Jordan18122000/projet_esp32_src/30_src/readme.md

Sous-modules : librairies logicielles, scripts partagés, ….
