Jordan18122000/projet_esp32_src/30_src/ESP32/Empreintes.xlsx

NAME | Description | Designator | Qty | MP | Manufacturer | Footprint | V | Check
114020164 | Seeed Studio Accessories Grove Female Header - SMD-4P-2.0mm-90D-20Pcs | J202, J203 | 2 | KO | KO | 114020164 | NA | OK
598-8610-207F | Standard LEDs - SMD Red/Green WC 80/50mcd 645/570nm | D600 | 1 | KO | KO | 5988610207F | NA
0.1uF | Capa | C101, C104, C108, C300, C500 | 5 | KO | KO | CAPA_0603 | NA | OK
0.6pF | Capa | C600 | 1 | KO | KO | CAPA_0603 | NA | OK
0.9pF | Capa | C601 | 1 | KO | KO | CAPA_0603 | NA | OK
1nF | Capa | C105 | 1 | KO | KO | CAPA_0603 | NA | OK
1.0pF | Capa | C602 | 1 | KO | KO | CAPA_0603 | NA | OK
1uF | Capa | C100, C102, C103, C107, C303, C304 | 6 | KO | KO | CAPA_0603 | NA | OK
2.2uF | Capa | C302 | 1 | KO | KO | CAPA_0603 | NA | OK
4.7uF | Capa | C106 | 1 | KO | KO | CAPA_0603 | NA | OK
5mF | Capa | C400 | 1 | KO | KO | CAPA_0603 | NA | OK
10uF | Capa | C301 | 1 | KO | KO | CAPA_0603 | NA | OK
22uF | Capa | C305 | 1 | KO | KO | CAPA_0603 | NA | OK
47nF | Capa | C603, C604, C605, C606 | 4 | KO | KO | CAPA_0603 | NA | OK
100nF | Capa | C200, C401, C402, C403, C404, C405, C406, C407, C501, C502 | 10 | KO | KO | CAPA_0603 | NA | OK
825433-8 | Headers & Wire Housings 8P double for connection mikrobus | J200 | 1 | KO | KO | Connect-Mikrobus | NA
4.7uH | Self | L300 | 1 | KO | KO | LQPC1005X06N | NA
10uF | Capa | L301 | 1 | KO | KO | LQPC1005X06N | NA
NCP167BMX330TBG | Régulateurs de tension LDO LDO 700 MA ULTRA-LOW NOISE 3.3V | U300 | 1 | KO | KO | NCP167BMX330TBG | NA
CP2104-F03-GM | USB Bridge, USB to UART USB 2.0 UART Interface 24-QFN (4x4) | U101 | 1 | KO | KO | PQFN50P400X400X80_HS-25N | NA
ESP32-PICO-D4 | Système RF sur puce - SoC SIP module ESP32 with 4MByte Flash, Dual Core MCU, Wi-Fi & Bluetooth Combo, LGA48-pin, 7*7mm | U100 | 1 | KO | KO | PQFN50P700X700X104_HS-49N | NA
1K | Résistance | R600, R603 | 2 | KO | KO | RES_0603 | NA | OK
2K | Résistance | R502, R503 | 2 | KO | KO | RES_0603 | NA | OK
4.7K | Résistance | R100 | 1 | KO | KO | RES_0603 | NA | OK
5K1 | Résistance | R200, R201 | 2 | KO | KO | RES_0603 | NA | OK
5.1K | Résistance | R605, R607 | 2 | KO | KO | RES_0603 | NA | OK
10K | Résistance | R101, R102, R104, R401, R403, R405, R500, R501, R604, R606 | 10 | KO | KO | RES_0603 | NA | OK
10R | Résistance | R504, R505 | 2 | KO | KO | RES_0603 | NA | OK
22.1K | Résistance | R301 | 1 | KO | KO | RES_0603 | NA | OK
51K | Résistance | R300 | 1 | KO | KO | RES_0603 | NA | OK
100k | Résistance | R302 | 1 | KO | KO | RES_0603 | NA | OK
100K | Résistance | R400, R402, R404 | 3 | KO | KO | RES_0603 | NA | OK
150R | Résistance | R601, R602 | 2 | KO | KO | RES_0603 | NA | OK
510R | Résistance | R103 | 1 | KO | KO | RES_0603 | NA | OK
PSR400ITQFF0L50 | ROHM - PSR400ITQFF0L50 - SMD Current Sense Resistor, 500 ohm, PSR Series, 3921 [1052 Metric], 4 W, +/- 1%, Metal Strip | X500 | 1 | KO | KO | RESC10052X200N | NA
NB12K00103JBB | NTC SMD Thermistor, NB12K, 10K, 5% AVX 10k 0805 Protection NTC Thermistor, 5s, 2 x 1.25 x 1.3mm | B600, B601 | 2 | KO | KO | RESC2212X50N | NA
SD103AWS-7-F | Diode Array 3 Independent Schottky 40V 175mA Surface Mount 6-TSSOP, SC-88, SOT-363 | DARR700, DARR701, DARR702 | 3 | KO | KO | SD103AWS-7-F | NA
IS66WVS1M8BLL-104NLI | SRAM 8Mb, SerialRAM, 2.7V-3.6V, 104MHz, 8 pin SOIC 150 mil, RoHS | U102 | 1 | KO | KO | SOIC127P600X175-8N | NA
INA237AIDGST | Current Sense Amplifiers 85-V, 16-bit, I2C output current/voltage/power monitor with alert 10-VSSOP -40 to 125 | B500 | 1 | KO | KO | SOP50P490X110-10N | NA
TPS62056DGSG4 | TEXAS INSTRUMENTS - TPS62056DGSG4 - Synchronous Buck (Step Down) Switching Regulator, Fixed, 2.7V-10Vin, 3.3V/0.8A out, 850kHz, VSSOP-10 | B301 | 1 | KO | KO | SOP50P490X110-10N | NA
74VHC05FT | Logic Gates CMOS LOGIC IC INVERTER | B401 | 1 | KO | KO | SOP65P640X120-14N | NA
824011 | TVS Diode Array WE-TVS, High Speed Series - Low capazity - No leakage current - Low clamping voltage - high ESD voltage protection -- USB 1.0 - 2.0 | D200 | 1 | KO | KO | SOT23-5 | NA
MC74VHC1GT32DFT1G | Single 2-Input OR Gate, TTL Level | B400, B402, B403 | 3 | KO | KO | SOT65P210X110-5N | NA
TMP126DCKR | Board Mount Temperature Sensors +/-0.25 C SPI temperature sensor with 175 C operation, CRC and slew-rate alert | B501 | 1 | KO | KO | SOT65P210X110-6N | NA
FDV304P | ON SEMICONDUCTOR - FDV304P - Power MOSFET, P Channel, 25 V, 460 mA, 1.22 ohm, SOT-23, Surface Mount | Q400, Q401, Q402 | 3 | KO | KO | SOT95P251X112-3N | NA
LMR50410Y3FQDBVRQ1 | Régulateurs de tension de commutation Automotive qualified SIMPLE SWITCHER 4-V to 36-V, 1-A synchronous step-down converter 6-SOT-23 -40 to 150 | B300 | 1 | KO | KO | SOT95P280X145-6N | NA
2N7002KT1G | MOSFET N-Ch 60V 380mA Small Signal SOT23 ON Semiconductor 2N7002KT1G N-channel MOSFET Transistor, 380 mA, 60 V, 3-Pin SOT-23 | Q600 | 1 | KO | KO | SOT96P237X111-3N | NA
PKLCS1212E40A1-R1 | Buzzers Transducer, Externally Driven Piezo 1.5V 2kHz 70dB @ 1.5V, 10cm Surface Mount Solder Pads | LS600 | 1 | PKLCS1212E40A1-R1 | KO | SPKR_PKLCS1212E40A1-R1 | NA
SS8050-G | Bipolar Transistors - BJT NPN TRANSISTOR 1.5A 40V | Q100, Q101 | 2 | KO | KO | SS8050-G | NA
FSMSM | FSMSM Push Button Switch, 50 mA, -35 to 85 degC, 2-Pin SMD, RoHS, Bulk | SW200, SW201 | 2 | KO | TE Connectivity | TECO-FSMSM-2_V | 24V
Connecteur USB | Connecteurs USB USB Type C, 2.0, Rec, TH , G/F, RA , Top Mnt, T & R | J201 | 1 | KO | KO | USB4085-GF-A | NA
Filtre en mode commun | Bobines / filtres en mode commun WE-CNSW 1206 370mA 90Ohm 100MHz AECQ200 | L200 | 1 | KO | KO | WE-CNSW-1206 | NA
NN03-320 | Dual port antenna booster for GNSS, Bluetooth, 5G and UWB (1561 - 1606MHz, 2400 - 2500MHz, 3400 - 3800MHz, 3100 - 4800MHz and 6000 - 10600 MHz), signal booster | E600 | 1 | KO | KO | XCVR_NN03-320 | NA
