Jordan18122000/projet_esp32_src/50_out/Project Outputs/SCHEMA/ESP32_Projet.pdf

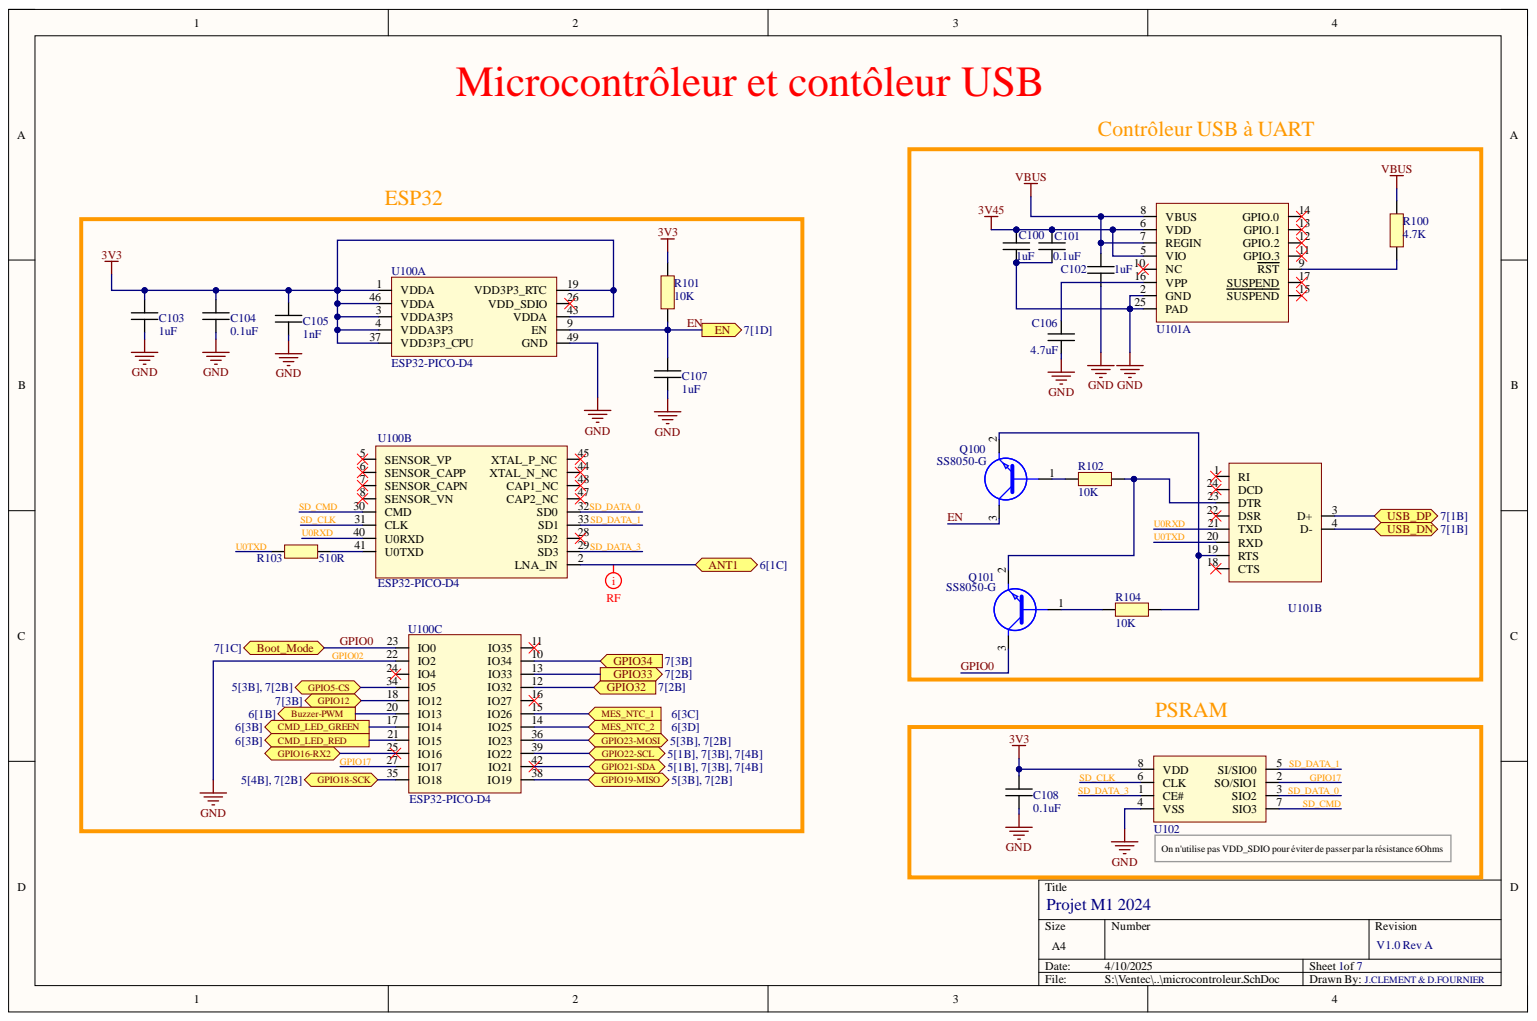
[picture p1: page 1]

4 | 6 | V D D A V D D _SD I O V D D A 3 P 3 V D D A V D D A 3 P 3 E N V D D 3P3 _ C PU G N D | 2 6 3

2 3 5[3B], 7[2B] GP IO5-C S 1 7[3 B ] GP IO1 2 2 6[1 B ] Buz z e r -PWM 1 6[3 B ] C MD_L ED_GR EEN 2 6[3 B ] C MD_L ED_R ED 2 GP IO16-R X 2 | 4 | 13 2 IO33

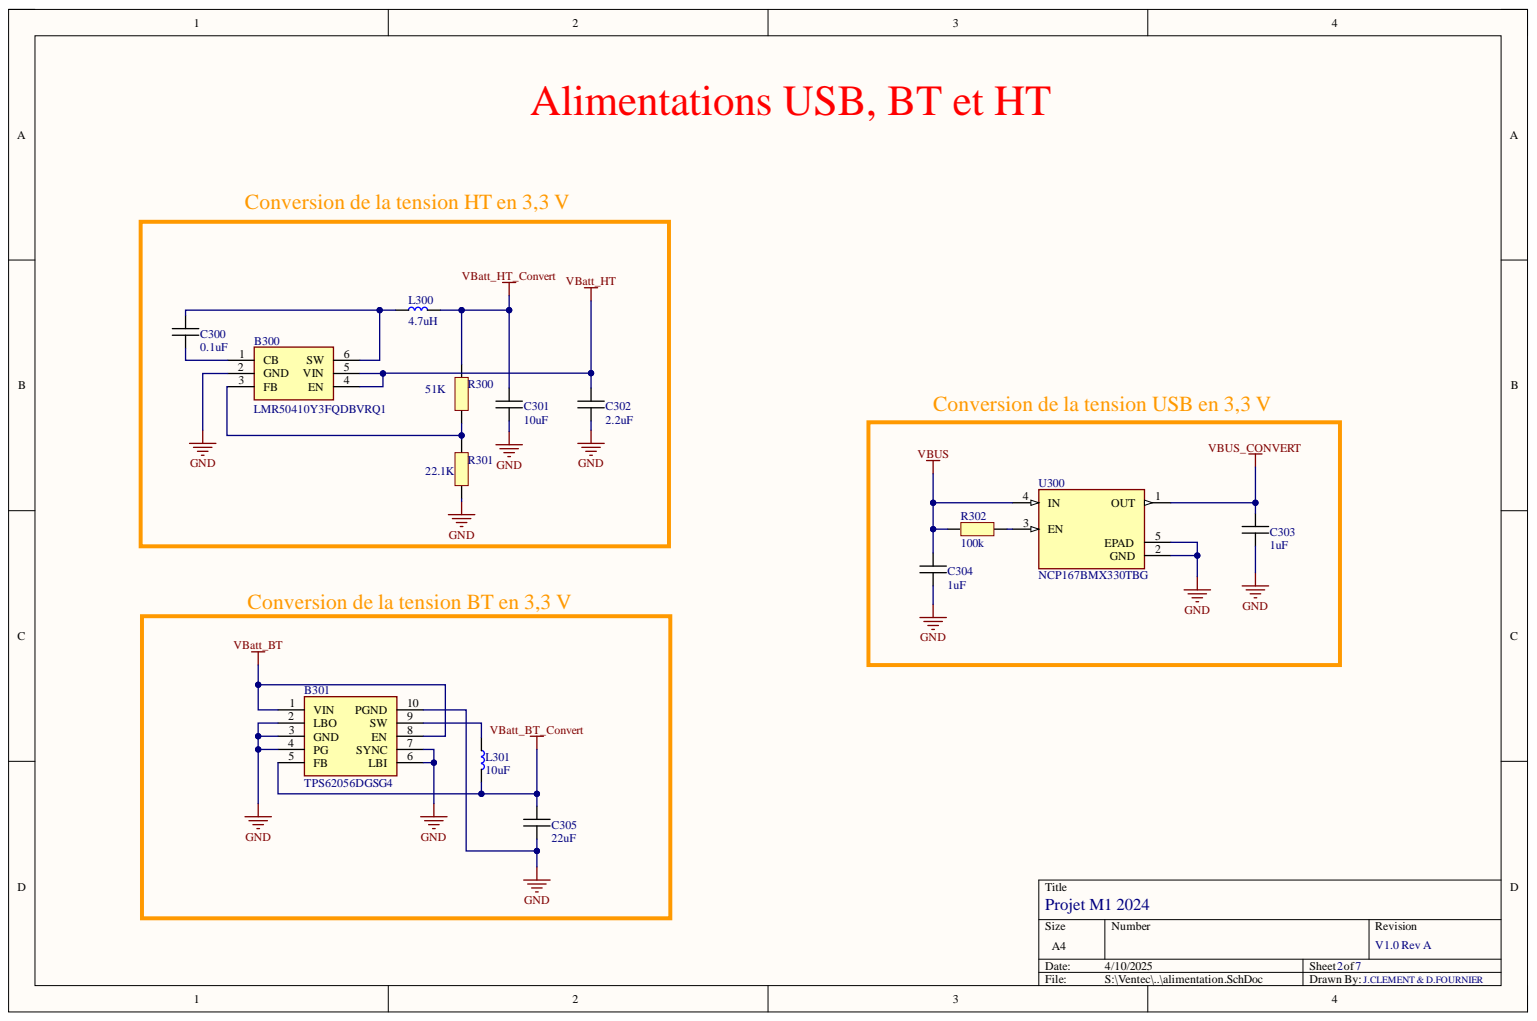
[picture p2: page 2]

Alimentations USB, BT et HT VBatt_HT

FB E N

FB LBI

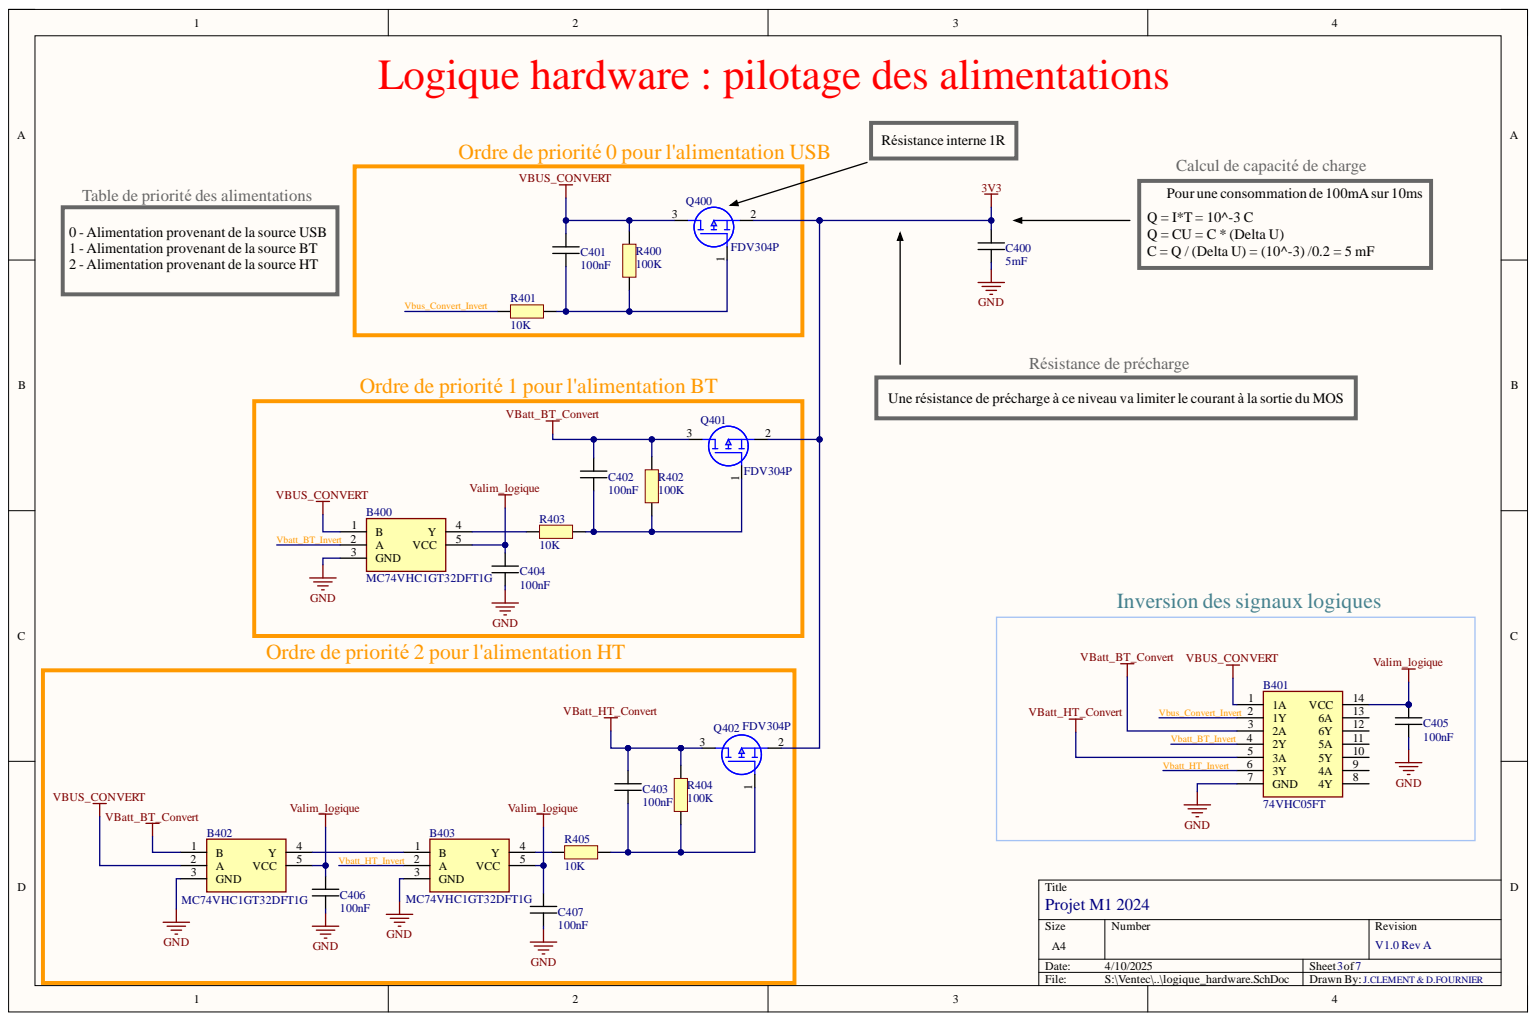
[picture p3: page 3]

Logique hardware : pilotage des alimentations

Ordre de priorité 0 pour l'alimentation USB

Calcul de capacité de charge

Table de priorité des alimentations

Pour une consommation de 100mAsur 10ms
Q = CU = C * (Delta U)
C = Q / (Delta U) = (10^-3) /0.2 = 5 mF

0 - Alimentation provenant de la source USB
1 - Alimentation provenant de la source BT
2 - Alimentation provenant de la source HT

Ordre de priorité 1 pour l'alimentation BT

Une résistance de précharge à ce niveau va limiter le courant à la sortie du MOS

Ordre de priorité 2 pour l'alimentation HT

A 2 | Vbatt_HT_Invert | A 2
GND 3 | | GND 3

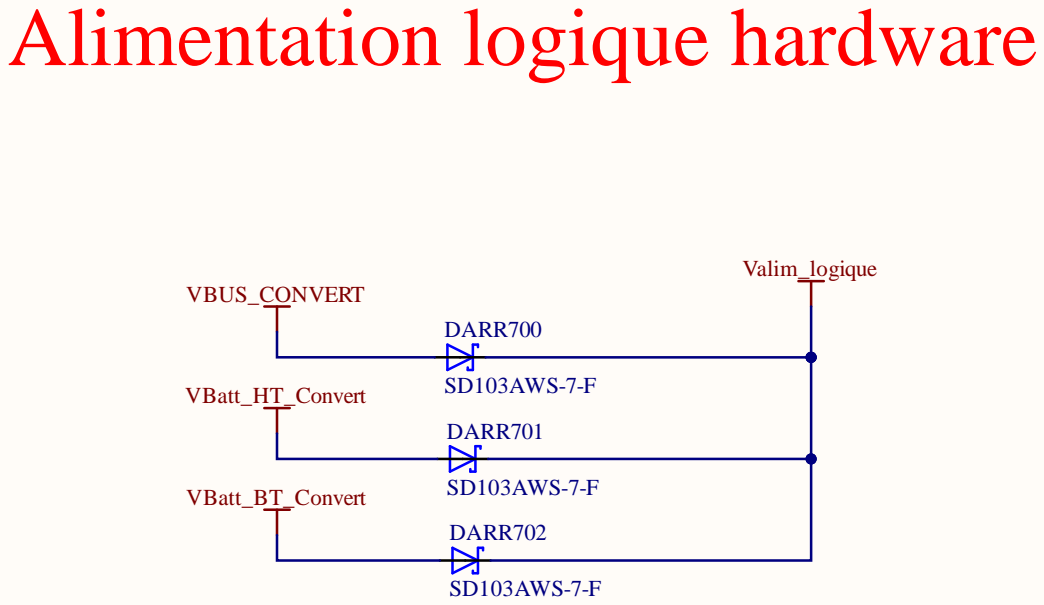
[picture p4: page 4]

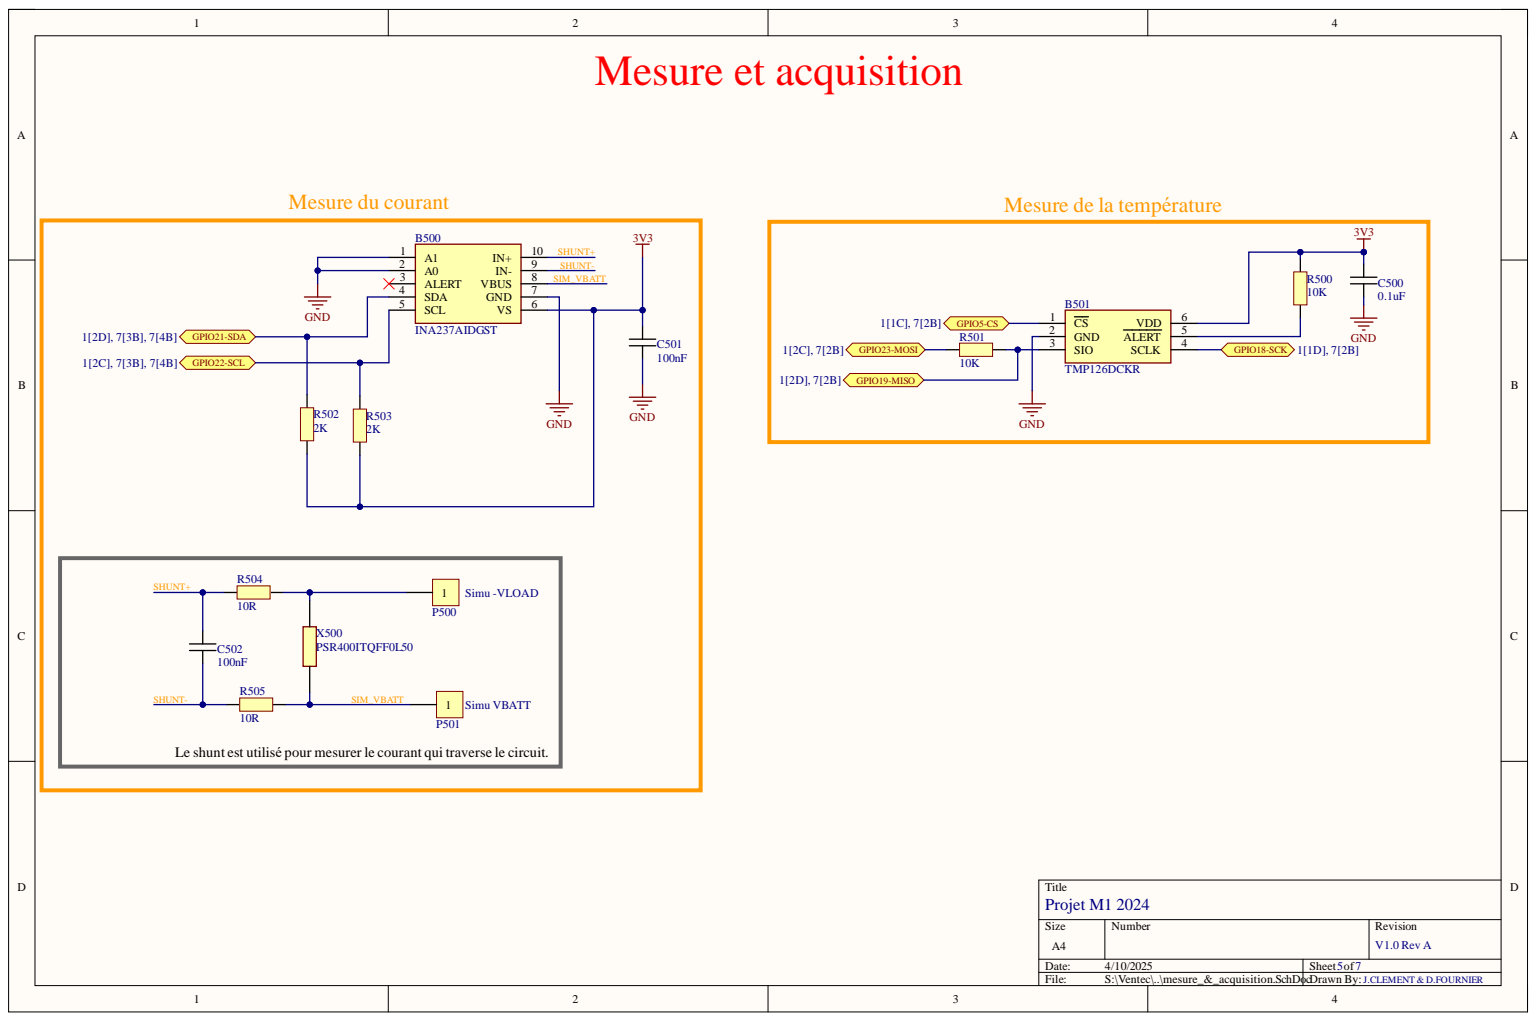
[picture p5: page 5]

2 | 9 | SHUNT -ATT
3 | | 8 7 | S I M_VB

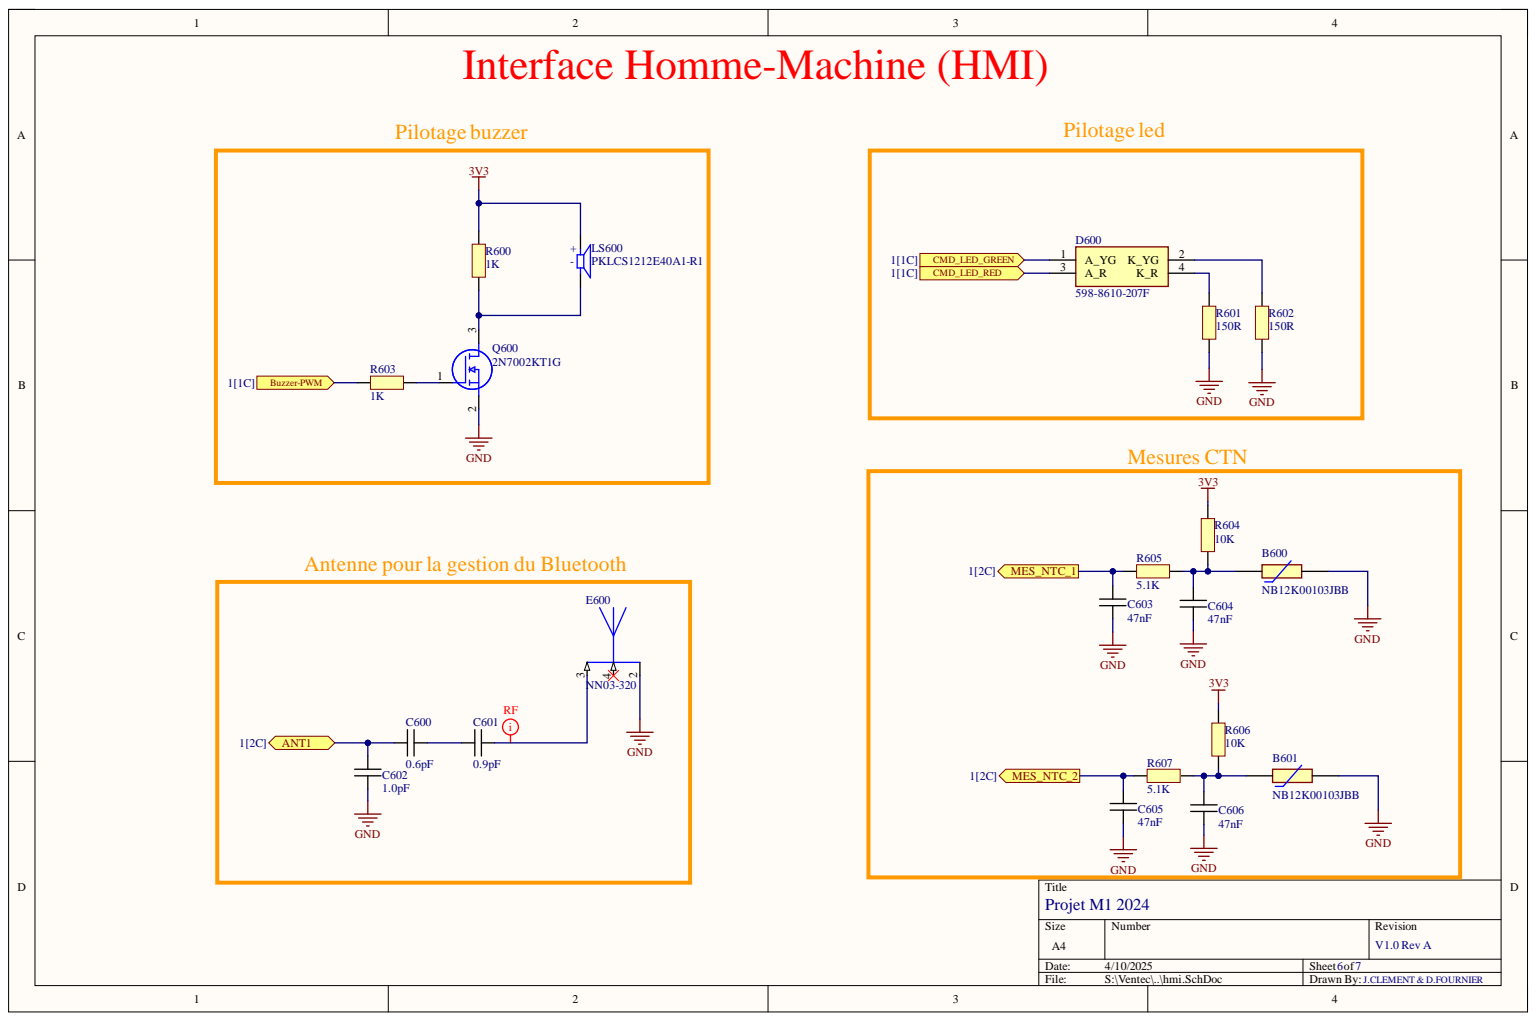
[picture p6: page 6]

Interface Homme-Machine (HMI)

Antenne pour la gestion du Bluetooth

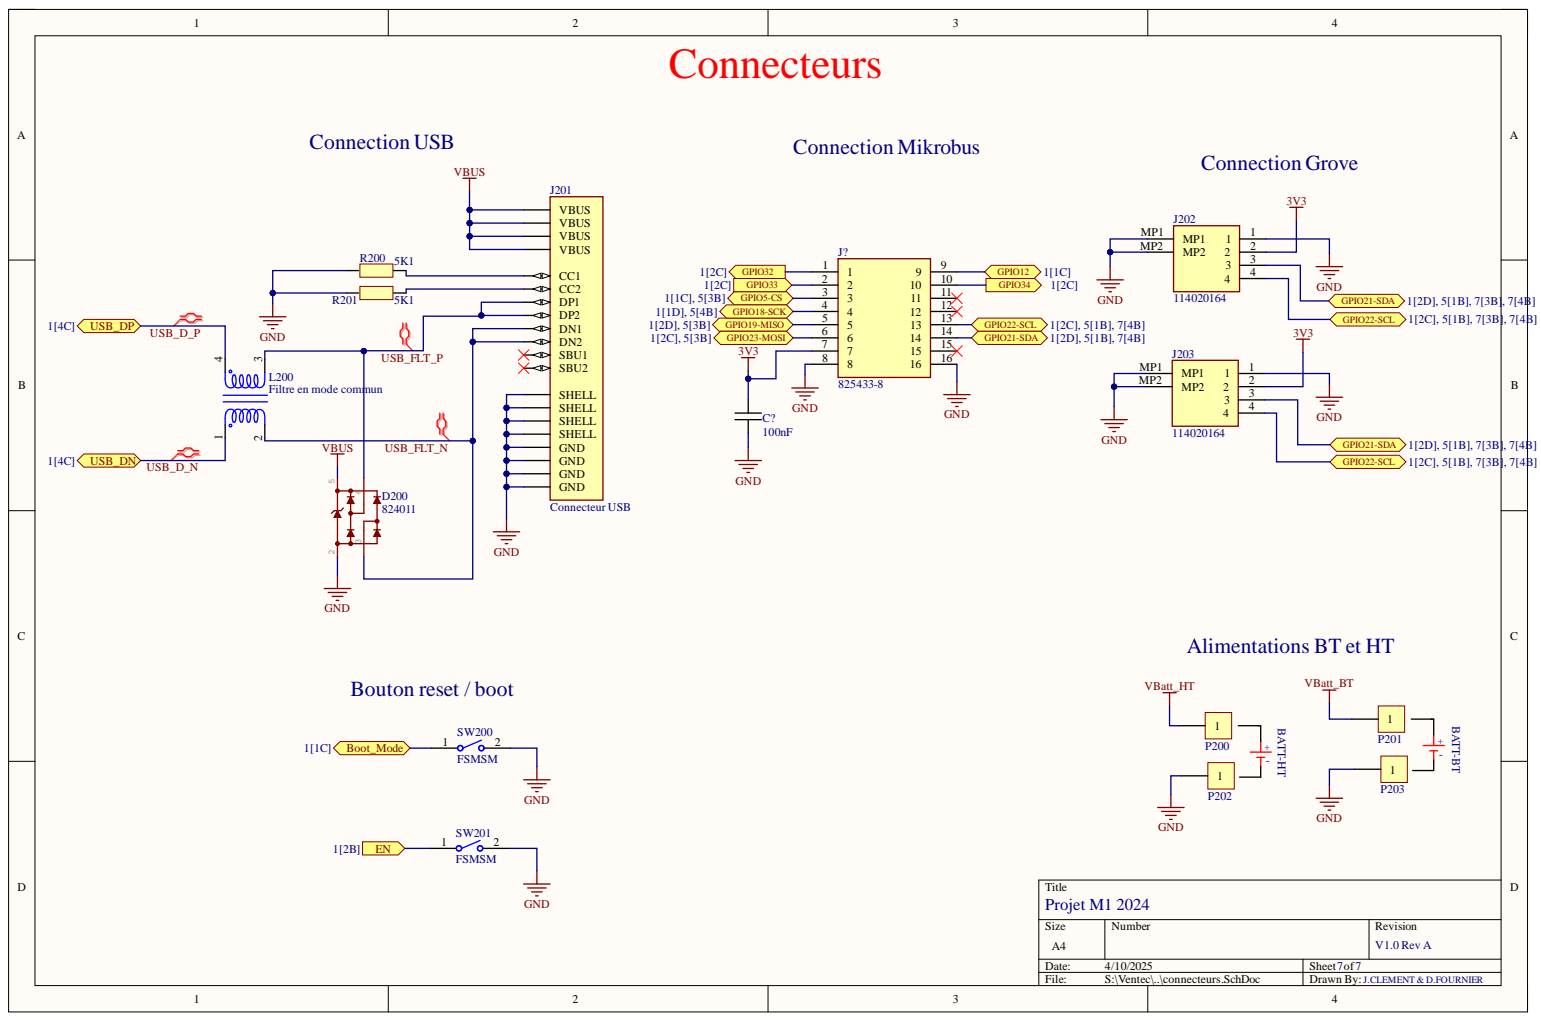
[picture p7: page 7]

Filtre en mode commun

Alimentations BT et HT
