Jordan18122000/projet_esp32_src/(list of files, drawings)

Other design files:
30_src/ESP32/ESP32_Project/ESP32_Projet.PrjPcb
30_src/ESP32/ESP32_Project/PCB1.PcbDoc
30_src/ESP32/ESP32_Project/PCBLibrary.PcbLib
30_src/ESP32/ESP32_Project/SCHLibrary.SchLib
30_src/ESP32/ESP32_Project/Sheet1.SchDoc
30_src/ESP32/ESP32_Projet.PrjPcb
30_src/ESP32/PCBLibrary.PcbLib
30_src/ESP32/SCHEMA/alim_logique_hard.SchDoc
30_src/ESP32/SCHEMA/alimentation.SchDoc
30_src/ESP32/SCHEMA/connecteurs.SchDoc
30_src/ESP32/SCHEMA/hmi.SchDoc
30_src/ESP32/SCHEMA/logique_hardware.SchDoc
30_src/ESP32/SCHEMA/mesure_&_acquisition.SchDoc
30_src/ESP32/SCHEMA/microcontroleur.SchDoc
30_src/ESP32/SCHLibrary.SchLib
